buteomont/Water-Flow-Counter/resources/KiCad/WaterFlowCounter/Version 2.1/waterFlowCounterBoard.jpg

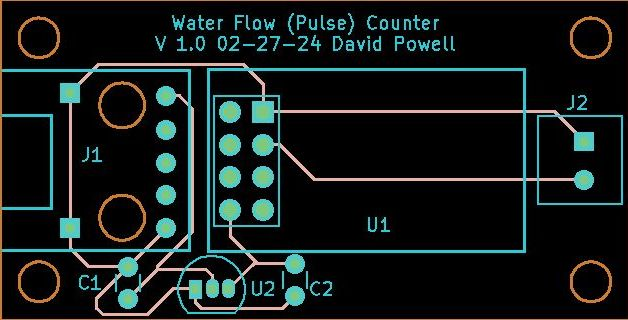
resources/KiCad/WaterFlowCounter/Version 2.1/waterFlowCounterBoard.jpg
