buteomont/Water-Flow-Counter/resources/FreeCAD/WaterFlowCounter.FCStd

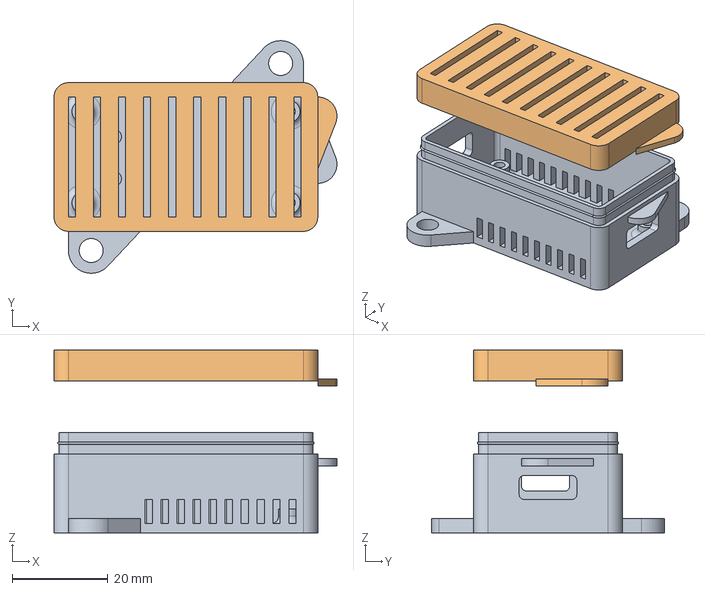
[picture p2: CAD file, 2024-03-19]
resources/FreeCAD/WaterFlowCounter.FCStd
59.0 x 48.5 x 38.2 mm
BoxBody
LidBody
