buteomont/Water-Flow-Counter/resources/FreeCAD/WaterFlowCounter (stable copy 1).FCStd

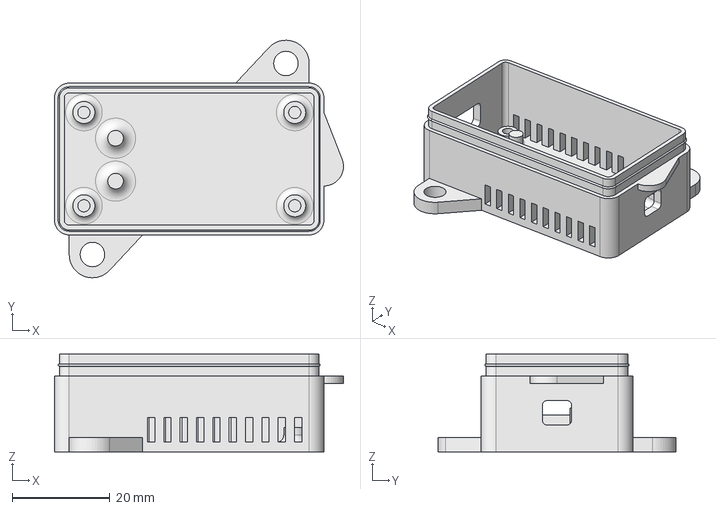
[picture p3: CAD file, 2024-03-19]
resources/FreeCAD/WaterFlowCounter (stable copy 1).FCStd
59.0 x 48.5 x 20.0 mm
