buteomont/Water-Flow-Counter/resources/FreeCAD/WaterFlowCounter-LidBody.stl

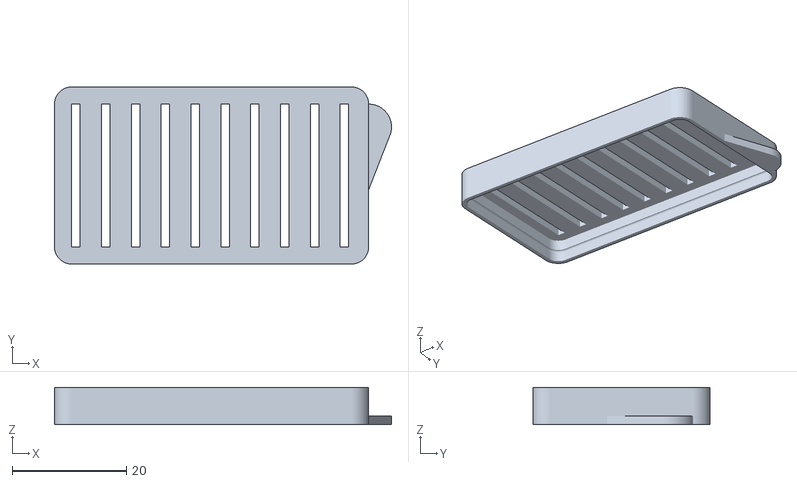
[picture p4: CAD file, 2024-03-19]
resources/FreeCAD/WaterFlowCounter-LidBody.stl
59.0 x 31.0 x 6.50
