buteomont/Water-Flow-Counter/resources/FreeCAD/WaterFlowCounter-Box.3mf

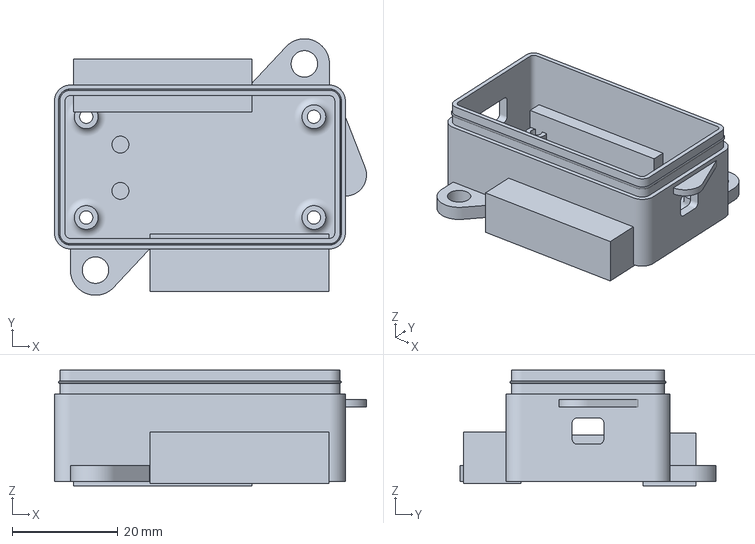
[picture p5: CAD file, 2024-03-19]
resources/FreeCAD/WaterFlowCounter-Box.3mf
59.0 x 48.5 x 21.9 mm
