buteomont/Water-Flow-Counter/resources/FreeCAD/WaterFlowCounter-BoxBody.stl

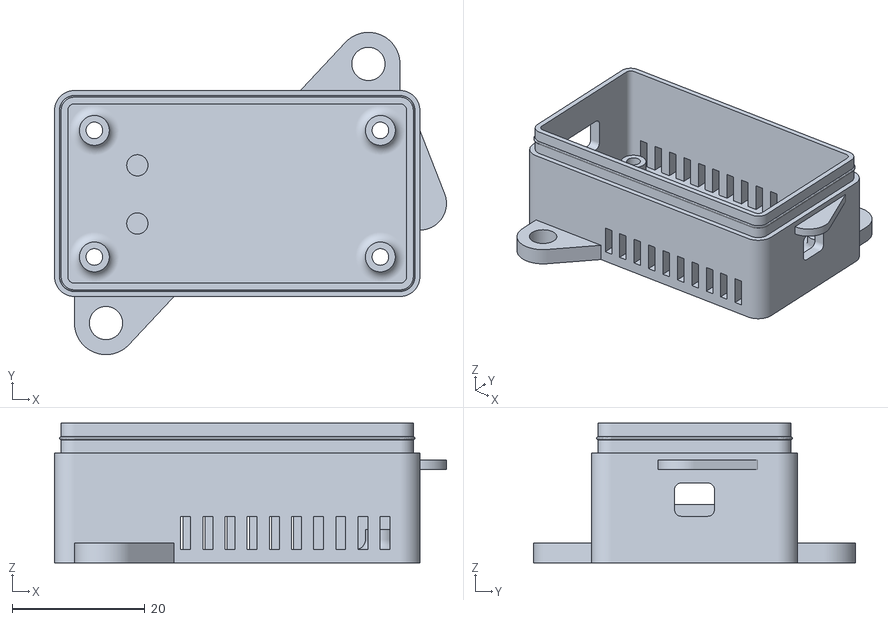
[picture p6: CAD file, 2024-03-19]
resources/FreeCAD/WaterFlowCounter-BoxBody.stl
59.0 x 48.5 x 21.0
