buteomont/Water-Flow-Counter/resources/KiCad/WaterFlowCounter/Version 2.1/WaterFlowCounter.kicad_pcb

## KiCad design resources/KiCad/WaterFlowCounter/Version 2.1/WaterFlowCounter.kicad_pcb (2024-04-02)

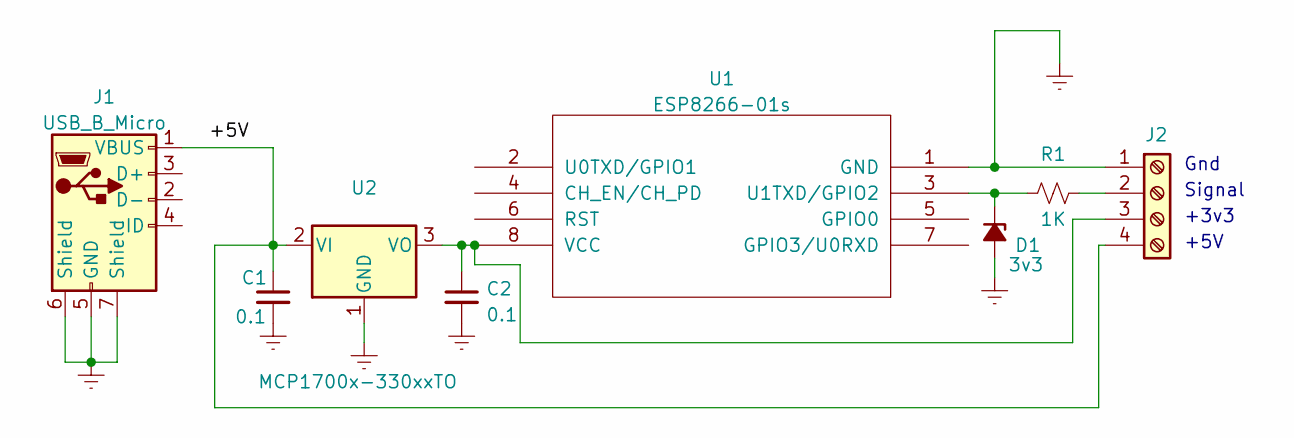
[picture p7: schematic WaterFlowCounter.kicad_sch, Water Flow Counter]

Parts:
C1, C2: 0.1; C_Disc_D3.0mm_W1.6mm_P2.50mm
D1: 3v3; D_A-405_P7.62mm_Horizontal
J1: USB_B_Micro; HW-769 Mini USB Socket Board
J2: Screw_Terminal_01x04; Screw Terminal Block x2 P3mm W685 H660
R1: 1K; R_Axial_DIN0204_L3.6mm_D1.6mm_P7.62mm_Horizontal
U1: ESP8266-01s
U2: MCP1700x-330xxTO; TO-92_Inline

Connections:
Earth: C1.2, C2.2, D1.2 (A), J1.5 (GND), J1.6 (Shield), J1.7 (Shield), J2.1, U1.1 (GND), U2.1 (GND)
unnamed: C1.1, J1.1 (VBUS), J2.4, U2.2 (VI)
unnamed: C2.1, J2.3, U1.8 (VCC), U2.3 (VO)
unnamed: D1.1 (K), R1.1, U1.3 (U1TXD/GPIO2)
unnamed: J2.2, R1.2

Notes on the sheet:
+3v3
+5V
Signal
Gnd

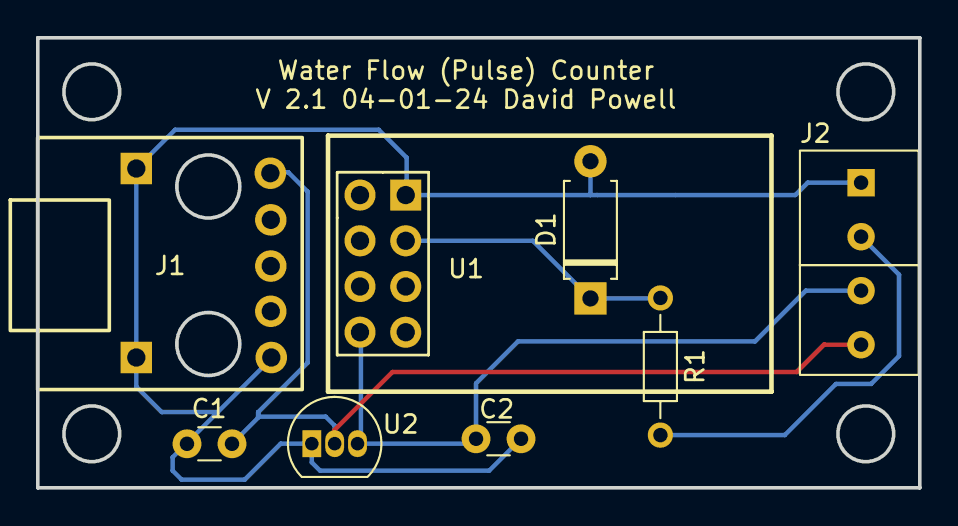
[picture p8: board resources/KiCad/WaterFlowCounter/Version 2.1/WaterFlowCounter.kicad_p… from above]

Board: 2 copper layers, 49.0 x 25.0 mm, 8 parts (0 on the bottom side), 5 nets.
