buteomont/Water-Flow-Counter/resources/KiCad/WaterFlowCounter/Version 1.0/WaterFlowCounter.kicad_pcb

## KiCad design resources/KiCad/WaterFlowCounter/Version 1.0/WaterFlowCounter.kicad_pcb (2024-03-19, an earlier design)

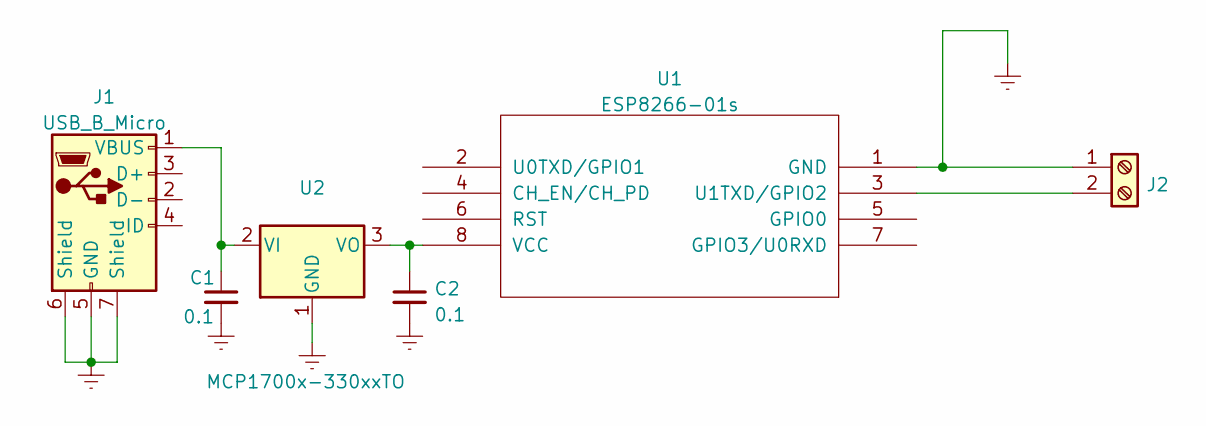
[picture p9: schematic WaterFlowCounter.kicad_sch]

Parts:
C1, C2: 0.1; C_Disc_D3.0mm_W1.6mm_P2.50mm
J1: USB_B_Micro; HW-769 Mini USB Socket Board
J2: Screw_Terminal_01x02; Screw Terminal Block P3mm W685 H660
U1: ESP8266-01s
U2: MCP1700x-330xxTO; TO-92_Inline

Connections:
Earth: C1.2, C2.2, J1.5 (GND), J1.6 (Shield), J1.7 (Shield), J2.1, U1.1 (GND), U2.1 (GND)
unnamed: J2.2, U1.3 (U1TXD/GPIO2)
unnamed: C2.1, U1.8 (VCC), U2.3 (VO)
unnamed: C1.1, J1.1 (VBUS), U2.2 (VI)

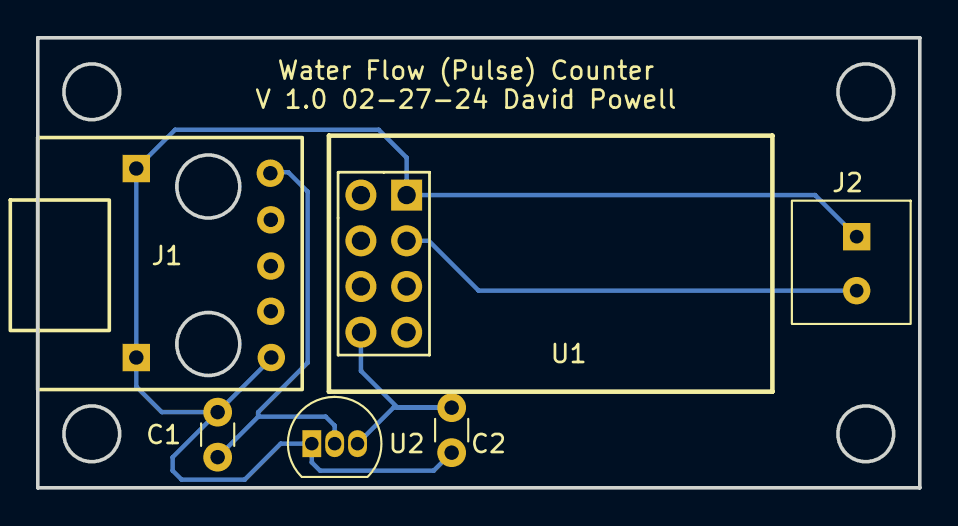
[picture p10: board resources/KiCad/WaterFlowCounter/Version 1.0/WaterFlowCounter.kicad_p… from above]

Board: 2 copper layers, 49.0 x 25.0 mm, 6 parts (0 on the bottom side), 4 nets.
