buteomont/Water-Flow-Counter/include/mqtt_flow_counter.h

#define VALID_SETTINGS_FLAG 0xDAB0
#define SSID_SIZE 100
#define PASSWORD_SIZE 50
#define ADDRESS_SIZE 30
#define USERNAME_SIZE 50
#define MQTT_TOPIC_SIZE 150
#define MQTT_CLIENT_ID_SIZE 20
#define MQTT_CLIENT_ROOT "Pulse-Counter-"
#define MQTT_TOPIC_RAW "pulses"
#define MQTT_TOPIC_LITERS "liters"
#define MQTT_TOPIC_PERIOD "period"
#define MQTT_TOPIC_SAVE_PULSE_COUNT "countSaved"
#define MQTT_TOPIC_COMMAND_REQUEST "command"
#define MQTT_TOPIC_INFO "info"
#define MQTT_PAYLOAD_SETTINGS_COMMAND "settings" //show all user accessable settings
#define MQTT_PAYLOAD_RESET_PULSE_COMMAND "resetPulseCounter" //reset the pulse counter to zero
#define MQTT_PAYLOAD_REBOOT_COMMAND "reboot" //reboot the controller
#define MQTT_PAYLOAD_VERSION_COMMAND "version" //show the version number
#define MQTT_PAYLOAD_STATUS_COMMAND "status" //show the most recent flow values
#define JSON_STATUS_SIZE SSID_SIZE+PASSWORD_SIZE+USERNAME_SIZE+MQTT_TOPIC_SIZE+MQTT_CLIENT_ID_SIZE+50 //+50 for associated field names, etc
#define DEBOUNCE_DELAY 20
//#define LED_BUILTIN 2     //the blue LED on ESP32
#define DEFAULT_REPORT_INTERVAL 15 //seconds. Should be 60 IRL
#define MAX_WIFI_WAIT_COUNT 100 //maximum number of dots to print when connecting to wifi
#define DEFAULT_PULSES_PER_LITER 419.51 //was 396.0

#ifdef BOARD_D1_MINI
  #define SENSOR_PIN D5  // GPIO14 is on pin D5 of the Wemos D1 mini
#else
  #define SENSOR_PIN 2   // GPIO2 is on pin 3 of the ESP8266-01S. Also the blue LED
#endif

// Error codes copied from the MQTT library
// #define MQTT_CONNECTION_REFUSED            -2
// #define MQTT_CONNECTION_TIMEOUT            -1
// #define MQTT_SUCCESS                        0
// #define MQTT_UNACCEPTABLE_PROTOCOL_VERSION  1
// #define MQTT_IDENTIFIER_REJECTED            2
// #define MQTT_SERVER_UNAVAILABLE             3
// #define MQTT_BAD_USER_NAME_OR_PASSWORD      4
// #define MQTT_NOT_AUTHORIZED                 5
  

//WiFi status codes
//0 : WL_IDLE_STATUS when Wi-Fi is in process of changing between statuses
//1 : WL_NO_SSID_AVAILin case configured SSID cannot be reached
//3 : WL_CONNECTED after successful connection is established
//4 : WL_CONNECT_FAILED if password is incorrect
//6 : WL_DISCONNECTED if module is not configured in station mode

//Function prototypes
void setup();
void incomingMqttHandler(char* reqTopic, byte* payload, unsigned int length);
void showSettings();
void reconnectToBroker();
String getConfigCommand();
void processCommand(char* cmd);
void initializeSettings();
void loop();
void checkForCommand();
void report();
boolean publish(char* topic, char* reading);
void loadSettings();
boolean saveSettings();
void resetPulseCounter();
char* getMqttSettings();
const char* getVersion();
boolean getMqttStatus();
boolean storePulseCount();
void loadPulseCount();
void incomingSerial();
void handleInterrupt(); 
void handlePulse();
void sendReport();
boolean connectToWifi();

//PubSubClient callback function header.  This must appear before the PubSubClient constructor.
void incomingMqttHandler(char* reqTopic, byte* payload, unsigned int length);
