buteomont/Water-Flow-Counter/(commit log)

2024-02-25 Moved to an interrupt-based model
2024-03-07 lots of changes
    [WaterFlowCounter-BoxBody.stl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]
2024-03-19 Modified board to present voltages externally
    [WaterFlowCounter (stable copy 1).FCStd, WaterFlowCounter-Box.3mf, WaterFlowCounter-BoxBody.stl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]
2024-03-20 Fixed invalid JSON for settings MQTT
    [main.cpp]
2024-04-02 Minor code changes, added resistor to schematic and board
    [WaterFlowCounter.kicad_pcb, WaterFlowCounter.kicad_sch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]
2024-04-16 Modified interrupt handling
2024-04-19 Added sensorType to settings
